imihajlow/ethernet-to-spi/waveforms/eth.png

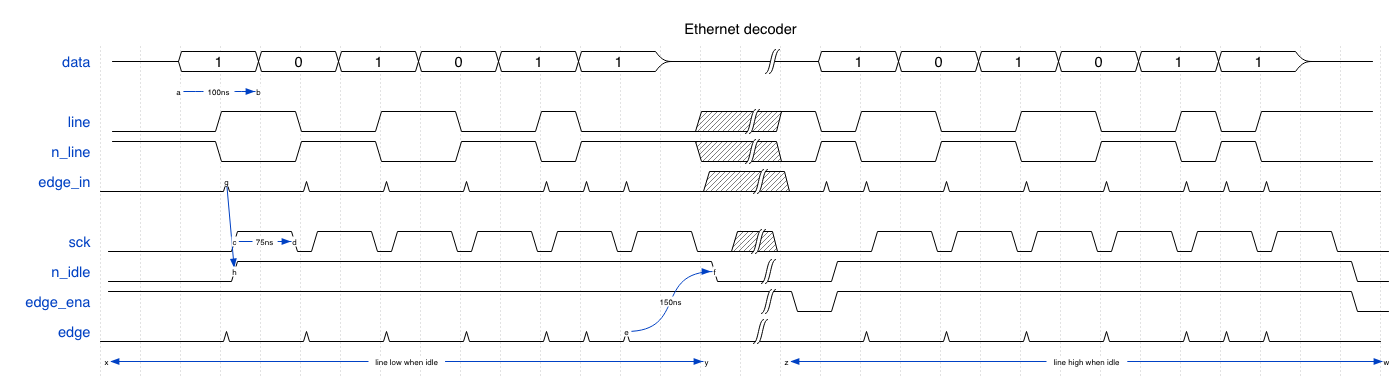
waveforms/eth.png
