imihajlow/ethernet-to-spi/sch/shield/ERRATA.md

# Revision 1

Pin 1 of U8 should be connected to GND.
