imihajlow/ethernet-to-spi/(commit log)

2022-09-04 SPI to UART
2022-09-04 Reset SPI after each transfer
    [main.rs]
2022-09-07 Model and schematics of a receiver
    [ethernet-to-spi.kicad_pcb, ethernet-to-spi.kicad_sch]
2022-09-07 Change SPI bit order and CS polarity
2022-09-08 Fix first edge filter circuit, create PCB
    [ethernet-to-spi.kicad_pcb, ethernet-to-spi.kicad_sch]
2022-09-09 Add level shifters for inputs
    [ethernet-to-spi.kicad_pcb, ethernet-to-spi.kicad_sch]
2022-09-11 Update capacitor value for 75 nS delay
    [ethernet-to-spi.kicad_pcb, ethernet-to-spi.kicad_sch]
2022-09-11 Gerber files
    [ethernet-to-spi-Edge_Cuts.gbr, ethernet-to-spi-F_Cu.gbr, ethernet-to-spi.drl]
2022-09-18 NLP generator
    [nlpgen.kicad_pcb, nlpgen.kicad_sch]
2022-09-19 NLP generator board
    [nlpgen.kicad_pcb, nlpgen.kicad_sch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]
2022-09-19 Device for smoltcp
2022-09-21 Pad frames to 64 bytes
2022-10-19 Porting to STM32F401 WIP
2022-11-06 Byte synchronization module + STM32F401 program (works partially)
    [bytesync.kicad_pcb, bytesync.kicad_sch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]
2022-11-08 Receiver: try flipping first bit, recover on false edges
    [main.rs, receiver.rs]
2022-11-13 New transmitter board
    [shield.kicad_pcb, shield.kicad_sch, transmitter.kicad_pcb, transmitter.kicad_sch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]
2022-11-13 Fix NLP polarity
    [transmitter.kicad_pcb, transmitter.kicad_sch]
2022-11-15 Shield schematic
    [shield.kicad_sch]
2022-11-17 Shield board
    [shield.kicad_pcb, shield.kicad_sch]
2022-11-17 Shield board production files
    [shield-B_Cu.gbr, shield-B_Mask.gbr, shield-B_Paste.gbr, shield-B_Silkscreen.gbr, shield-Edge_Cuts.gbr, shield-F_Cu.gbr, shield-F_Mask.gbr, shield-F_Paste.gbr]
2022-11-25 Fix error in board
    [shield.kicad_pcb, shield.kicad_sch]
2022-12-03 Async select message and button event
2022-12-05 Echo a message and notify of button press
