imihajlow/ethernet-to-spi/(notices)

Notices in the files:
sch/shield/shield.kicad_pcb:
Licensed under the TAPR Open Hardware License (www.tapr.org/OHL)
Licensed under the TAPR OHL
